Bot-Ro-Bot/IRC_2018/arena.jpg

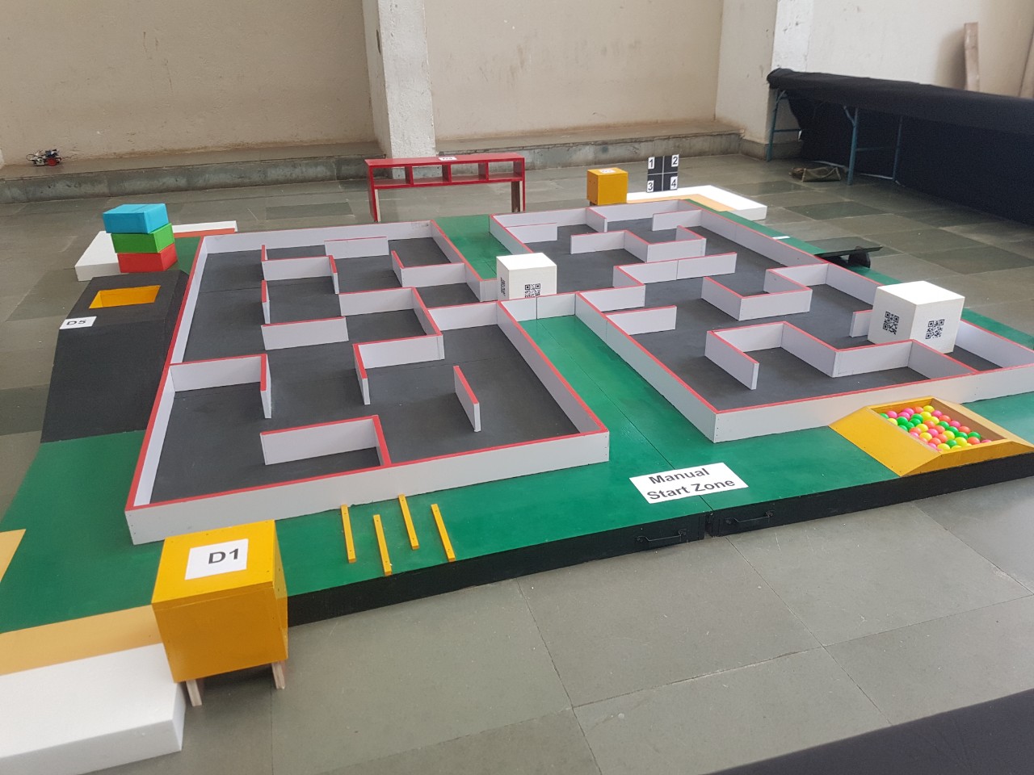
arena.jpg
