Bot-Ro-Bot/IRC_2018/README.md

# IRC_2018
This repo contains the codes, circuits and pcbs and also the documentation for the manual bot built to participate in the International Robotics Challange(IRC) in 2018 at TechFest held by IIT Bombay
.
