Bot-Ro-Bot/IRC_2018/PCB/BluePill.png

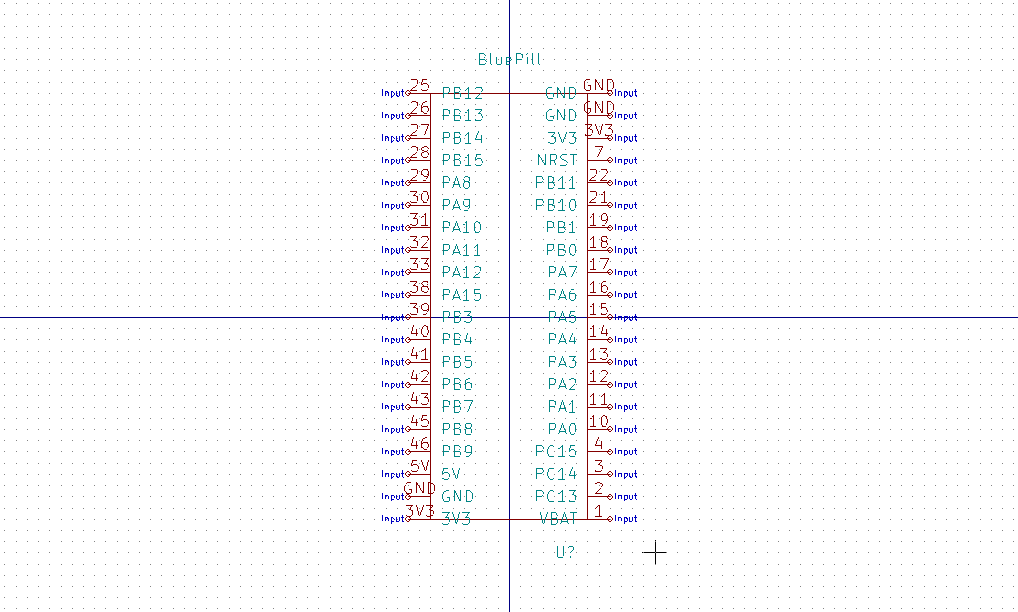
PCB/BluePill.png
