Bot-Ro-Bot/IRC_2018/PCB/abc.pdf

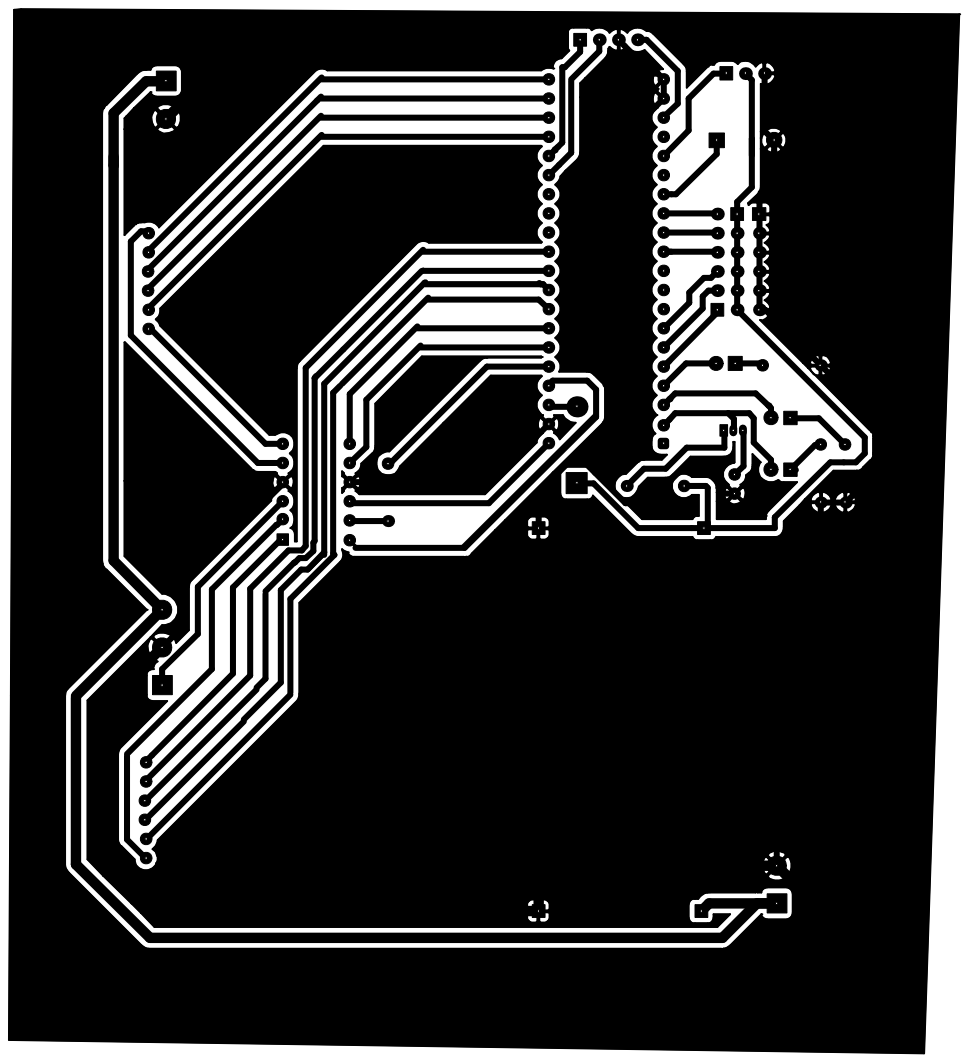
[picture p12: page 1]
