Bot-Ro-Bot/IRC_2018/PCB/mosfet_H_bridge/mosfet_H_bridge.pdf

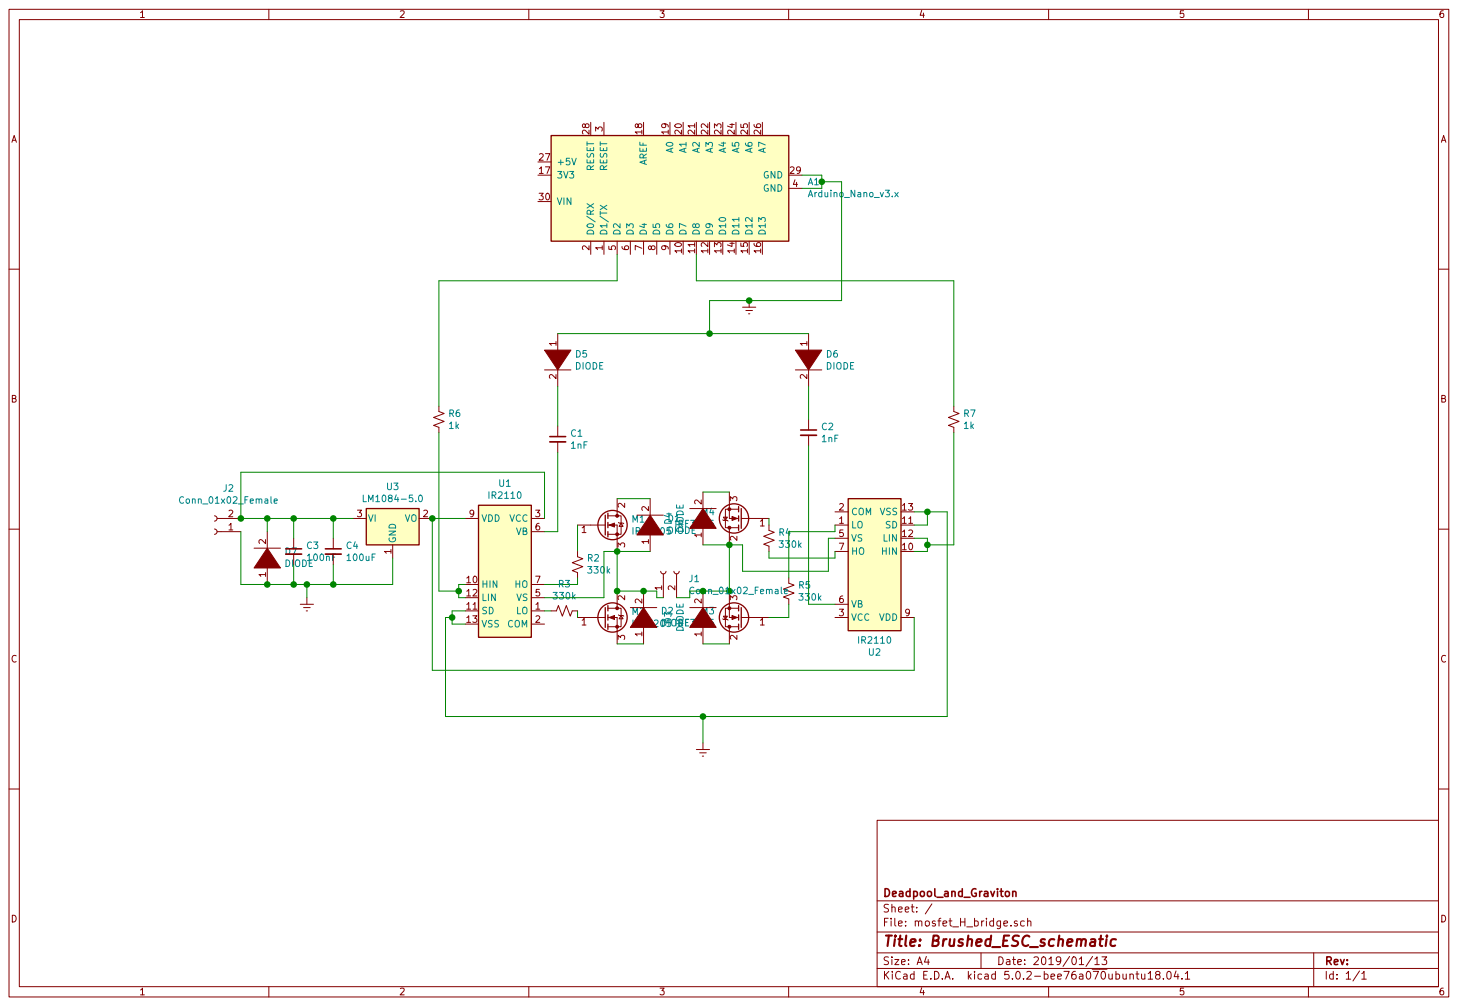
[picture p13: page 1]
