Bot-Ro-Bot/IRC_2018/PCB/just for fun.kicad_pcb

## KiCad design PCB/just for fun.kicad_pcb (2020-01-24)

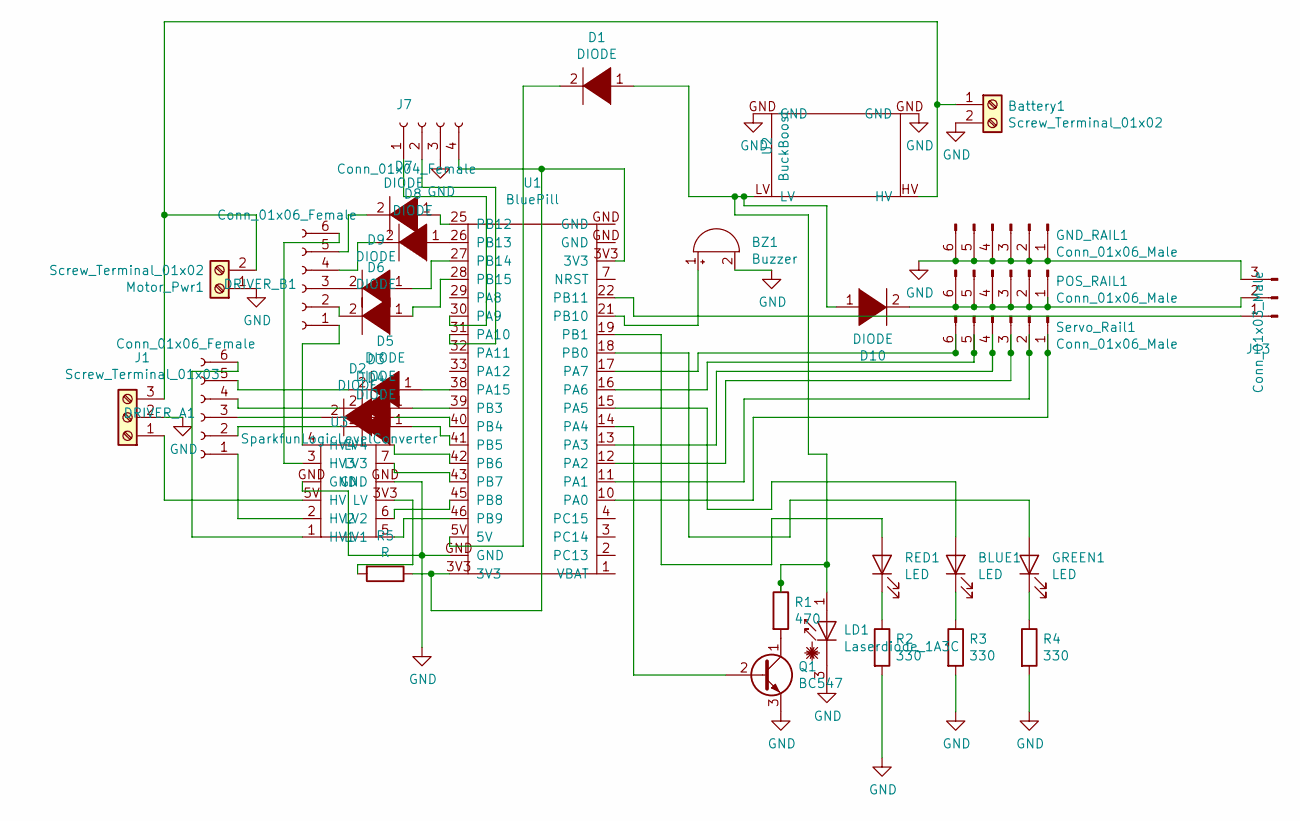
[picture p14: schematic just for fun.sch, ManualBot]

Parts:
BLUE1: LED; LED_D5.0mm
BZ1: Buzzer; Buzzer_12x9.5RM7.6
Battery1: Screw_Terminal_01x02; TerminalBlock_MetzConnect_Type094_RT03502HBLU_1x02_P5.00mm_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
D1, D2, D3, D4, D5, D6, D7, D8, D9, D10: DIODE; D_DO-15_P12.70mm_Horizontal
DRIVER_A1: Conn_01x06_Female; L298N
DRIVER_B1: Conn_01x06_Female; L298N
GND_RAIL1: Conn_01x06_Male; PinHeader_1x06_P2.54mm_Horizontal
GREEN1: LED; LED_D5.0mm
J1: Screw_Terminal_01x03; TerminalBlock_MetzConnect_Type094_RT03503HBLU_1x03_P5.00mm_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
J7: Conn_01x04_Female; PinHeader_1x04_P2.54mm_Horizontal
J13: Conn_01x03_Male; PinHeader_1x03_P2.54mm_Horizontal
LD1: Laserdiode_1A3C; LASER
Motor_Pwr1: Screw_Terminal_01x02; TerminalBlock_MetzConnect_Type094_RT03502HBLU_1x02_P5.00mm_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
POS_RAIL1: Conn_01x06_Male; PinHeader_1x06_P2.54mm_Horizontal
Q1: BC547; TO-92_Inline
R1: 470; R_Axial_DIN0207_L6.3mm_D2.5mm_P7.62mm_Horizontal
R2, R3, R4: 330; R_Axial_DIN0207_L6.3mm_D2.5mm_P7.62mm_Horizontal
R5: R; R_Axial_DIN0207_L6.3mm_D2.5mm_P7.62mm_Horizontal
RED1: LED; LED_D5.0mm
Servo_Rail1: Conn_01x06_Male; PinHeader_1x06_P2.54mm_Horizontal
U1: BluePill; STM32BluePill
U2: BuckBoost; BuckBoostConverter(5A)
U3: SparkfunLogicLevelConverter; Logic_level

Connections:
GND: BZ1.2 (+), Battery1.2, GND_RAIL1.1, GND_RAIL1.2, GND_RAIL1.3, GND_RAIL1.4, GND_RAIL1.5, GND_RAIL1.6, J1.2, J7.3, J13.3, LD1.3 (K), Motor_Pwr1.1, Q1.3 (E), R2.2, R3.2, R4.2, U1.GND, U2.GND, U3.GND
unnamed: BLUE1.1 (K), R3.1
unnamed: BLUE1.2 (A), U1.15 (PA5)
unnamed: BZ1.1 (-), U1.21 (PB10)
unnamed: Battery1.1, J1.3, Motor_Pwr1.2, U2.HV
unnamed: D1.1 (K), D10.1 (K), LD1.1 (A), R1.1, U2.LV
unnamed: D1.2 (A), U1.5V
unnamed: D2.1 (K), U1.40 (PB4)
unnamed: D2.2 (A), DRIVER_A1.3
unnamed: D3.1 (K), U1.39 (PB3)
unnamed: D3.2 (A), DRIVER_A1.4
unnamed: D4.1 (K), U1.41 (PB5)
unnamed: D4.2 (A), DRIVER_A1.2
unnamed: D5.1 (K), U1.38 (PA15)
unnamed: D5.2 (A), DRIVER_A1.5
unnamed: D6.1 (K), U1.28 (PB15)
unnamed: D6.2 (A), DRIVER_B1.2
unnamed: D7.1 (K), U1.25 (PB12)
unnamed: D7.2 (A), DRIVER_B1.5
unnamed: D8.1 (K), U1.26 (PB13)
unnamed: D8.2 (A), DRIVER_B1.4
unnamed: D9.1 (K), U1.27 (PB14)
unnamed: D9.2 (A), DRIVER_B1.3
unnamed: D10.2 (A), J13.2, POS_RAIL1.1, POS_RAIL1.2, POS_RAIL1.3, POS_RAIL1.4, POS_RAIL1.5, POS_RAIL1.6
unnamed: DRIVER_A1.1, U3.2 (HV2)
unnamed: DRIVER_A1.6, U3.1 (HV1)
unnamed: DRIVER_B1.1, U3.4 (HV4)
unnamed: DRIVER_B1.6, U3.3 (HV3)
unnamed: GREEN1.1 (K), R4.1
unnamed: GREEN1.2 (A), U1.18 (PB0)
unnamed: J1.1, U3.5V (HV)
unnamed: J7.1, U1.30 (PA9)
unnamed: J7.2, U1.31 (PA10)
unnamed: J7.4, R5.1, U1.3V3
unnamed: J13.1, U1.22 (PB11)
unnamed: Q1.1 (C), R1.2
unnamed: Q1.2 (B), U1.14 (PA4)
unnamed: R2.1, RED1.1 (K)
unnamed: R5.2, U3.3V3 (LV)
unnamed: RED1.2 (A), U1.19 (PB1)
unnamed: Servo_Rail1.1, U1.10 (PA0)
unnamed: Servo_Rail1.2, U1.11 (PA1)
unnamed: Servo_Rail1.3, U1.12 (PA2)
unnamed: Servo_Rail1.4, U1.13 (PA3)
unnamed: Servo_Rail1.5, U1.16 (PA6)
unnamed: Servo_Rail1.6, U1.17 (PA7)
unnamed: U1.42 (PB6), U3.8 (LV4)
unnamed: U1.43 (PB7), U3.7 (LV3)
unnamed: U1.45 (PB8), U3.6 (LV2)
unnamed: U1.46 (PB9), U3.5 (LV1)

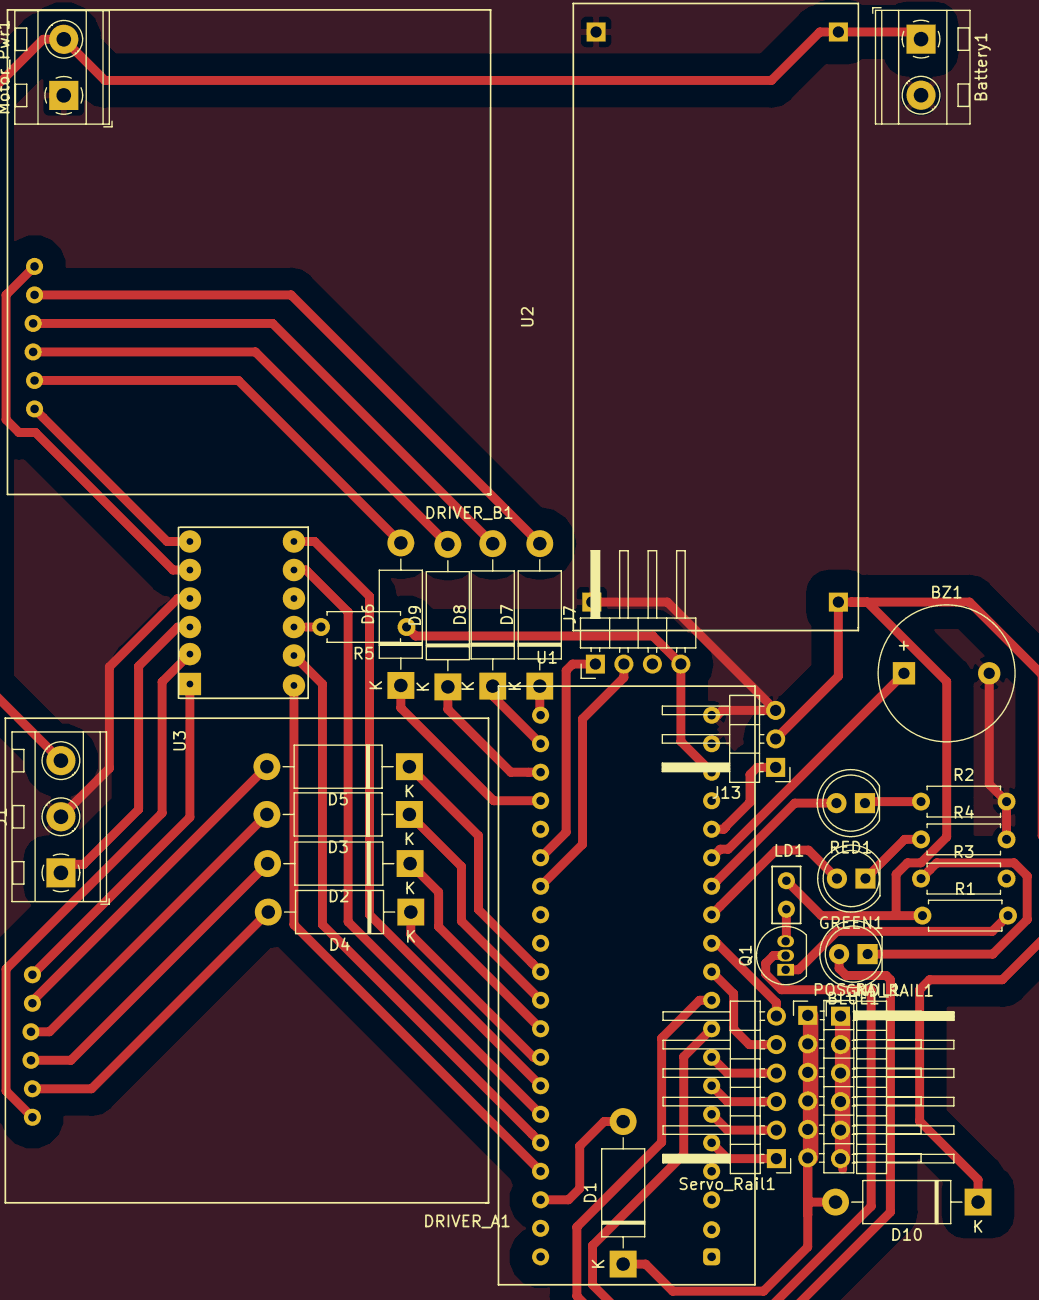
[picture p15: board just for fun.kicad_pcb from above]

Board: 2 copper layers, 34 parts (0 on the bottom side), 50 nets.
