Bot-Ro-Bot/IRC_2018/PCB/mosfet_H_bridge/mosfet_H_bridge.kicad_pcb

## KiCad design PCB/mosfet_H_bridge/mosfet_H_bridge.kicad_pcb (2020-01-24)

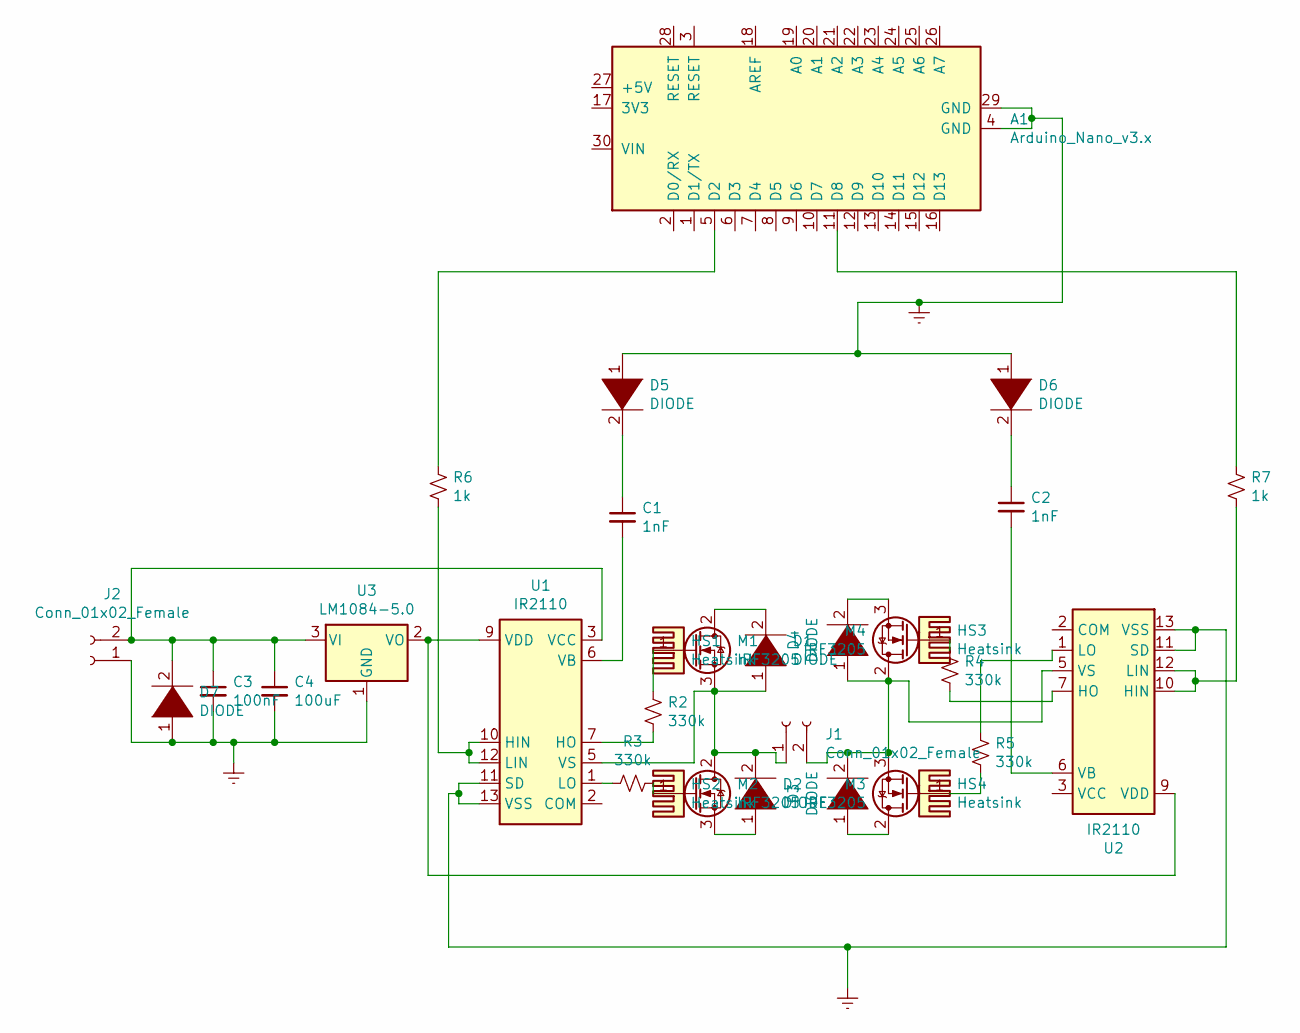
[picture p16: schematic mosfet_H_bridge.sch, Brushed_ESC_schematic]

Parts:
A1: Arduino_Nano_v3.x; Arduino_Nano
C1, C2: 1nF; C_Disc_D3.0mm_W1.6mm_P2.50mm
C3: 100nF; C_Disc_D3.0mm_W1.6mm_P2.50mm
C4: 100uF; C_Rect_L13.0mm_W4.0mm_P10.00mm_FKS3_FKP3_MKS4
D1, D2, D3, D4, D5, D6, D7: DIODE; D_A-405_P10.16mm_Horizontal
HS1, HS3, HS4: Heatsink; Heatsink_Aavid-TV5G_TO220_Horizontal
HS2: Heatsink; Heatsink_AAVID_573300D00010G_TO-263
J1, J2: Conn_01x02_Female; PinHeader_1x02_P2.54mm_Vertical
M1, M2, M3, M4: IRF3205; TO-220-3_Vertical
R2, R3, R4, R5: 330k; R_Axial_DIN0207_L6.3mm_D2.5mm_P10.16mm_Horizontal
R6, R7: 1k; R_Axial_DIN0207_L6.3mm_D2.5mm_P10.16mm_Horizontal
U1, U2: IR2110; DIP-14_W7.62mm_Socket
U3: LM1084-5.0; TO-220-3_Vertical

Connections:
Earth: A1.4 (GND), A1.29 (GND), C3.2, C4.2, D5.1 (K), D6.1 (K), D7.1 (K), J2.1, U1.11 (SD), U1.13 (VSS), U2.11 (SD), U2.13 (VSS), U3.1 (GND)
unnamed: A1.5 (D2), R6.1
unnamed: A1.11 (D8), R7.1
unnamed: C1.1, D5.2 (A)
unnamed: C1.2, U1.6 (VB)
unnamed: C2.1, D6.2 (A)
unnamed: C2.2, U2.6 (VB)
unnamed: C3.1, C4.1, D7.2 (A), J2.2, U1.3 (VCC), U3.3 (VI)
unnamed: D1.1 (K), D2.2 (A), J1.1, M1.3 (S), M2.2 (D), U1.5 (VS)
unnamed: D1.2 (A), M1.2 (D)
unnamed: D2.1 (K), M2.3 (S)
unnamed: D3.1 (K), M3.2 (D)
unnamed: D3.2 (A), D4.1 (K), J1.2, M3.3 (S), M4.2 (D), U2.5 (VS)
unnamed: D4.2 (A), M4.3 (S)
unnamed: M1.1 (G), R2.2
unnamed: M2.1 (G), R3.1
unnamed: M3.1 (G), R5.2
unnamed: M4.1 (G), R4.1
unnamed: R2.1, U1.7 (HO)
unnamed: R3.2, U1.1 (LO)
unnamed: R4.2, U2.7 (HO)
unnamed: R5.1, U2.1 (LO)
unnamed: R6.2, U1.10 (HIN), U1.12 (LIN)
unnamed: R7.2, U2.10 (HIN), U2.12 (LIN)
unnamed: U1.9 (VDD), U2.9 (VDD), U3.2 (VO)

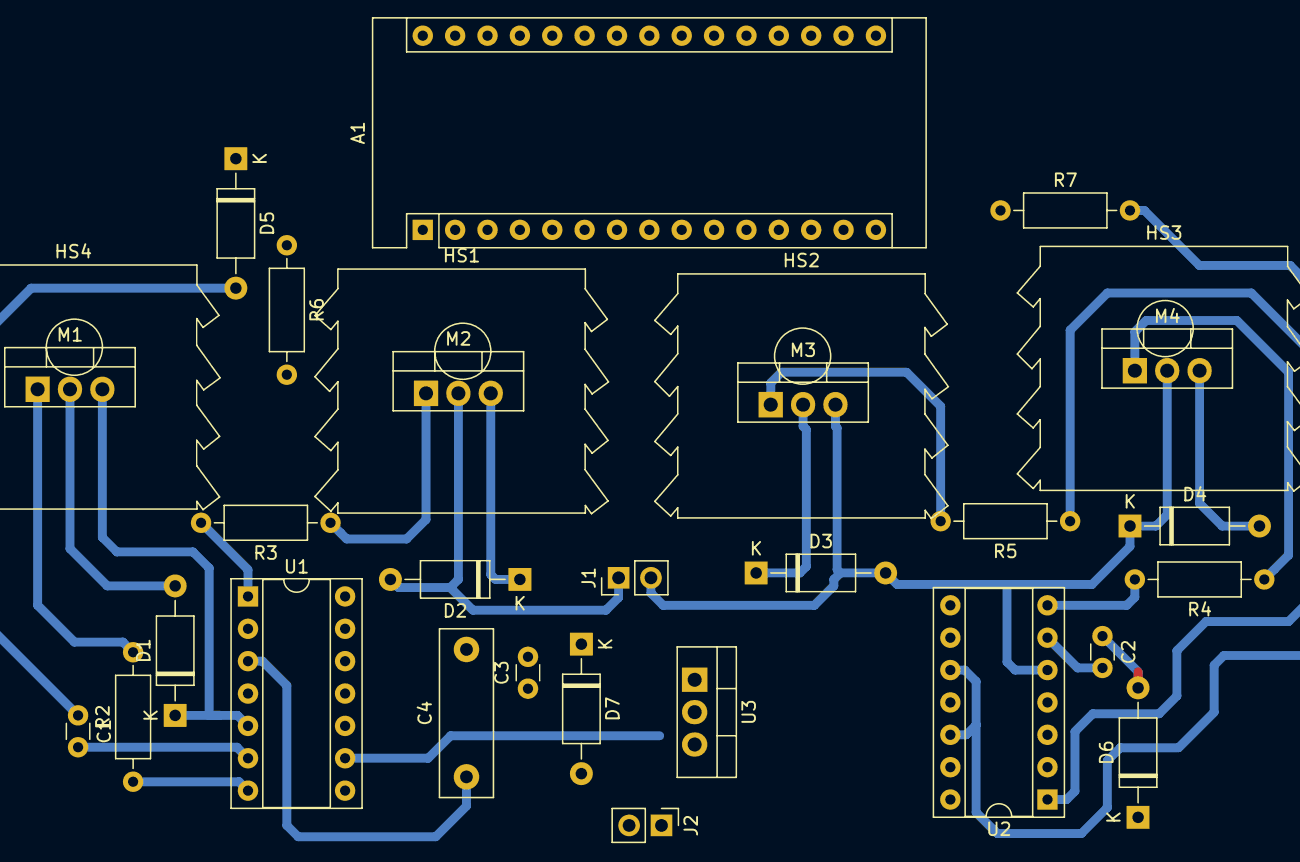
[picture p17: board mosfet_H_bridge.kicad_pcb from above]

Board: 2 copper layers, 31 parts (0 on the bottom side), 25 nets.
